dennisss/tansa/hardware/x260/README.md

260mm X Quadcopter Design
=========================

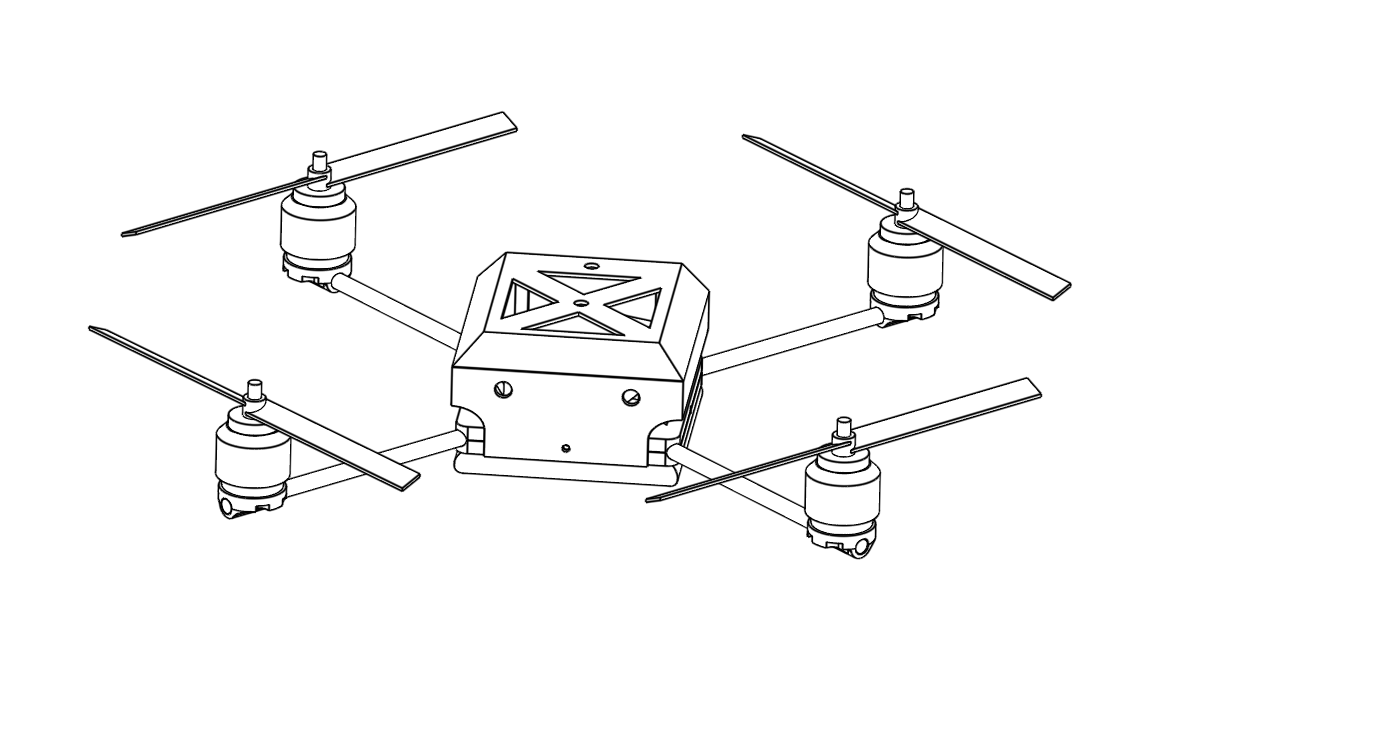
[picture p1: hardware/x260/wireframe.png]


Parts List
----------

- 4 of 138mm (length), 5mm (diameter) solid carbon fiber rods
	- https://hobbyking.com/en_us/turnigy-h-a-l-carbon-fiber-vertical-landing-skid-rod-5mm-x-250mm-4pcs-bag.html
- 2 of SLA/SLS printed center xframes
- 4 of SLA/SLS printed motor mounts
- PixRacer v1
- ACSP5 Power Board
- 4 of T-Motor MN1806 2300KV
- AfroESC Quattro 4 in 1 ESC
- Loctite Epoxy
- 2S 1500mAh LiPo Battery
- Assorted M3 Nylon Standoffs
- FrSky XM Receiver
