dennisss/tansa/hardware/x340/README.md

340mm X Quadcopter Design
=========================

Parts List
----------

- 4 T-Motor MT2208 Motors
- 1 Tenergy 3S 2700mAh Battery
- 1 PixRacer with ESP8266
- 1 AUAV ACSP4
- 4 AfroESC Slim 20A
- 2 Sparkfun Femtobuck LED drivers
- 2 Cree Cool White XPE-G2 LEDs
- 4 8030 Gemfan ABS propellers
- Assorted M3 screws
