dennisss/tansa/src/stereo/zed_info.txt

Use http://calib.stereolabs.com/?SN=1010 to get the factory calibration for the camera
