dennisss/tansa/src/stereo/full1.jpg

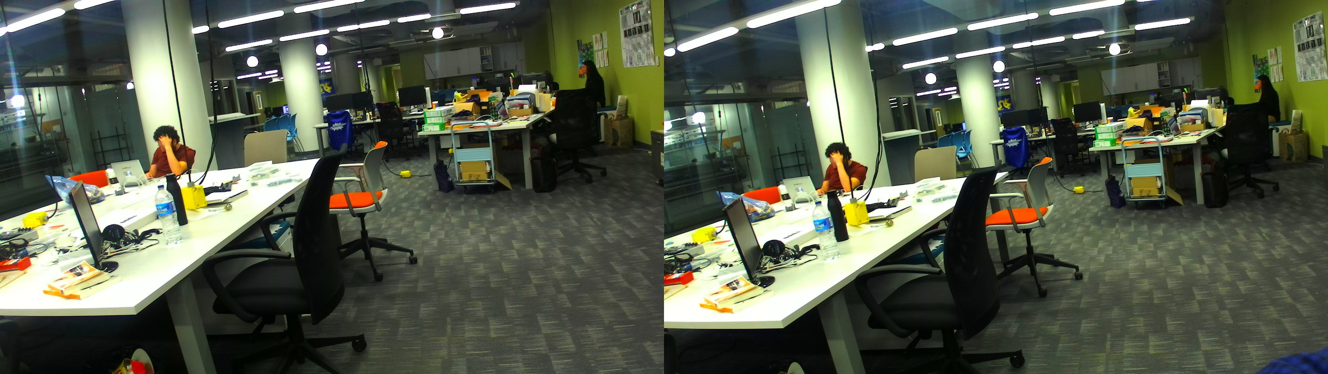
src/stereo/full1.jpg
