dennisss/tansa/src/stereo/full.jpg

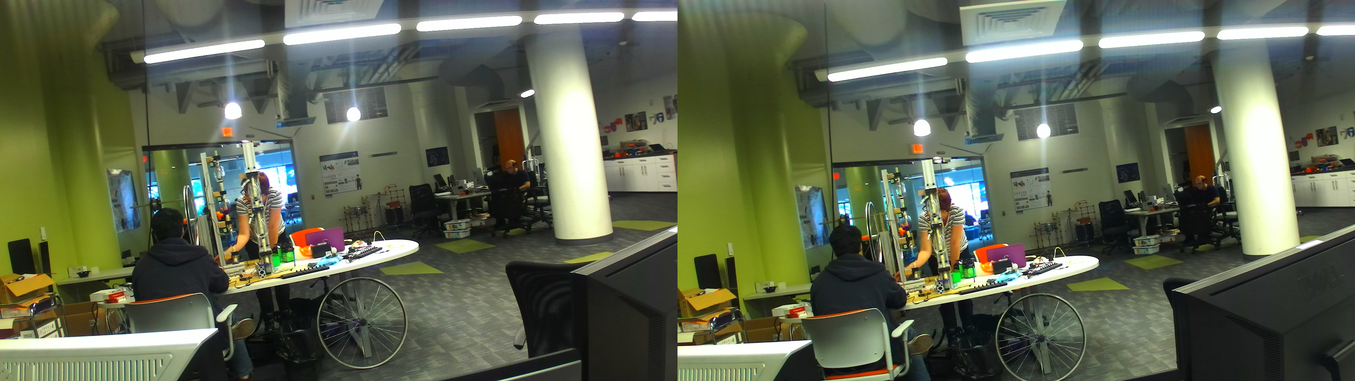
src/stereo/full.jpg
