dennisss/tansa/hardware/x260/active_ir/seeed_opl_bom.csv

Part/Designator | Manufacture Part Number/Seeed SKU | Quantity
R1 | 301010185 | 1
R2 | 301010196 | 1
R3,R4,R5 | 301010412 | 1
Q1 | 305030015 | 1
