dennisss/tansa/hardware/x260/mesh/shell.stl

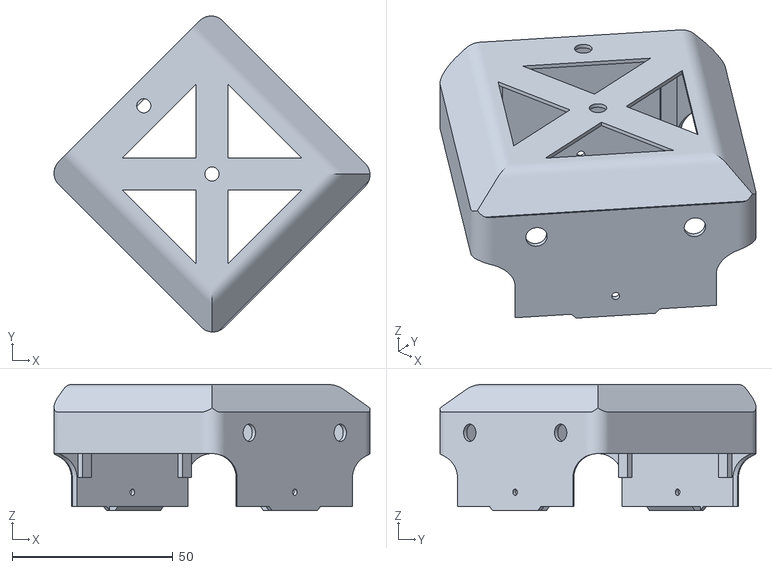
[picture p5: CAD file, 2017-04-13]
hardware/x260/mesh/shell.stl
98.2 x 98.2 x 39.2
