dennisss/tansa/hardware/x340/mesh/led-holder.stl

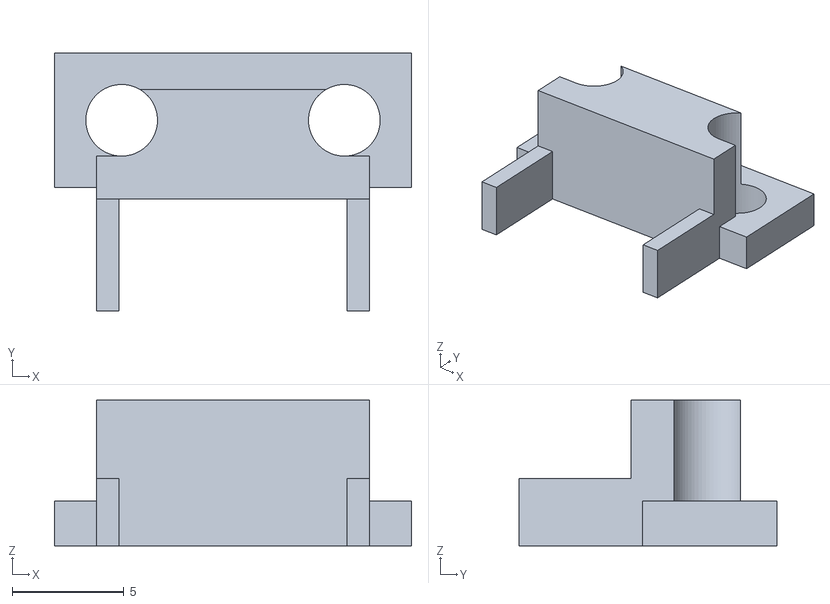
[picture p6: CAD file, 2017-03-05]
hardware/x340/mesh/led-holder.stl
15.9 x 11.5 x 6.50
