dennisss/tansa/public/models/propeller.stl

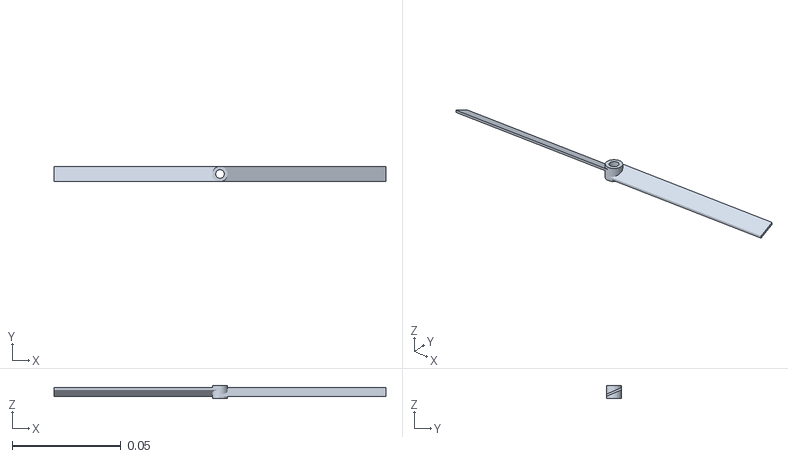
[picture p7: CAD file, 2017-03-05]
public/models/propeller.stl
0.152 x 0.007 x 0.006
