dennisss/tansa/hardware/x260/mesh/led-holder.stl

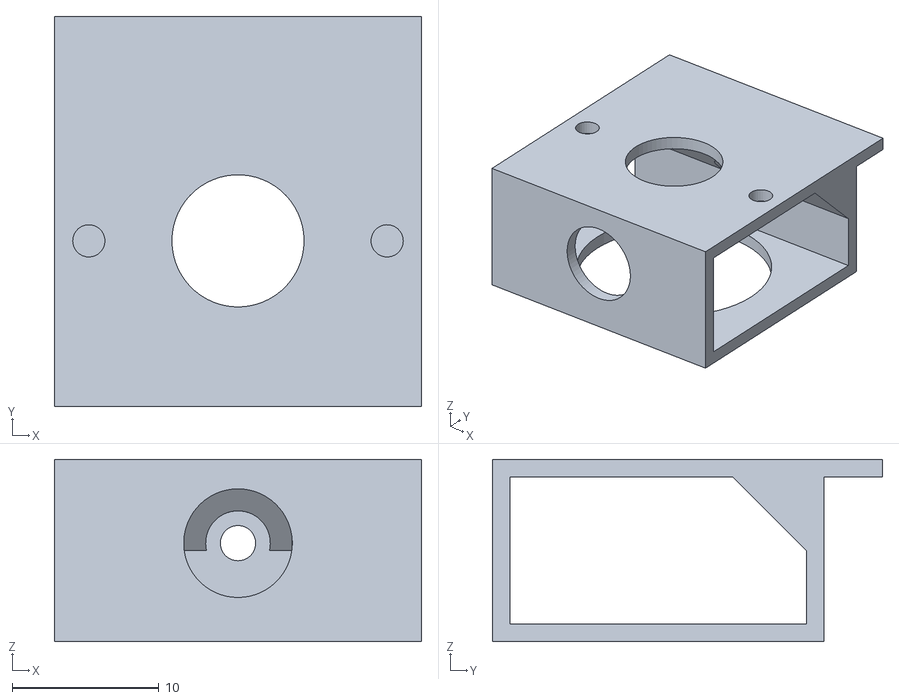
[picture p8: CAD file, 2017-04-13]
hardware/x260/mesh/led-holder.stl
25.0 x 26.6 x 12.4
