dennisss/tansa/hardware/x340/mesh/dot-rod-holder.stl

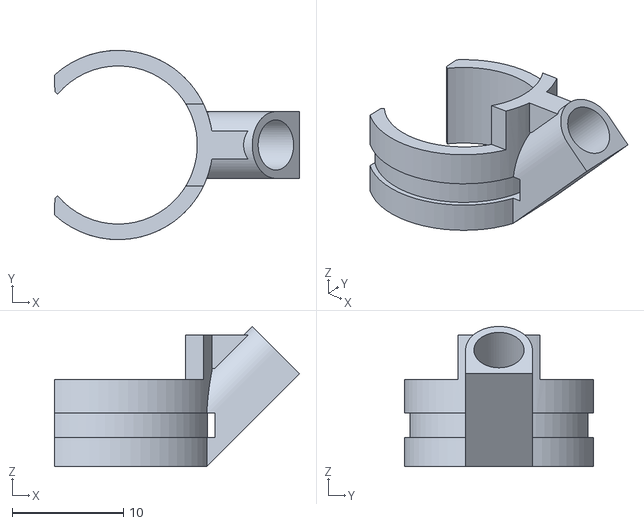
[picture p9: CAD file, 2016-11-03]
hardware/x340/mesh/dot-rod-holder.stl
22.0 x 17.0 x 12.6
