dennisss/tansa/public/models/body.stl

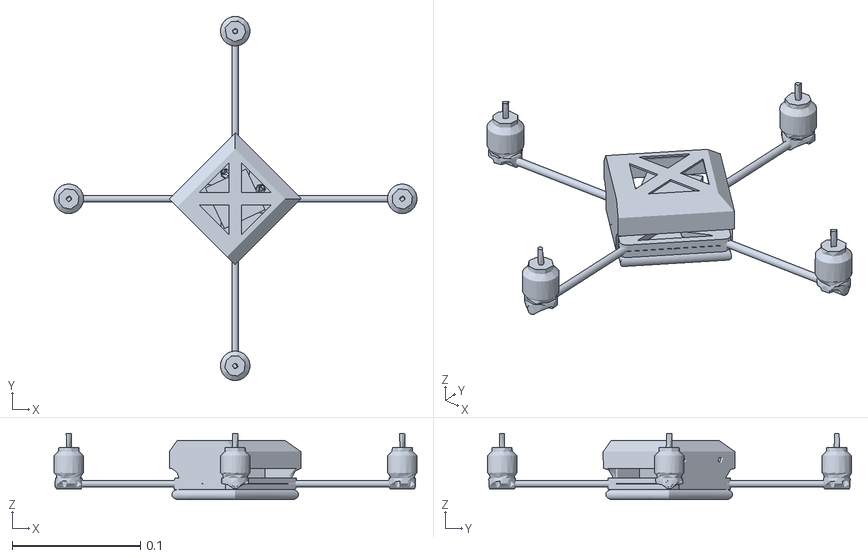
[picture p10: CAD file, 2017-03-05]
public/models/body.stl
0.283 x 0.284 x 0.0518
