dennisss/tansa/hardware/x260/mesh/cage.stl

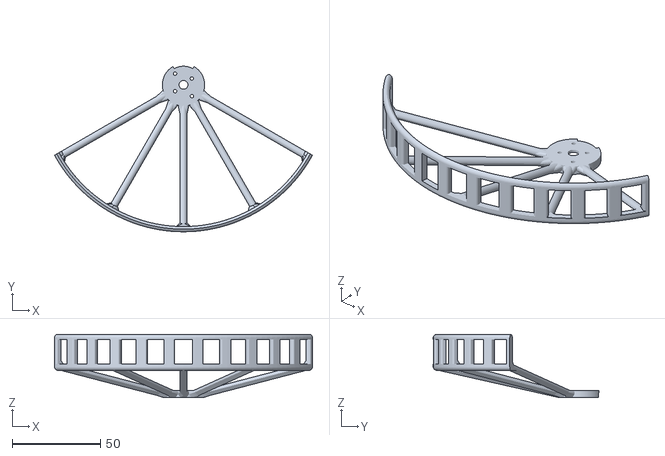
[picture p11: CAD file, 2017-04-13]
hardware/x260/mesh/cage.stl
146.6 x 94.1 x 35.9
