dennisss/tansa/hardware/x340/mesh/dot-holder.stl

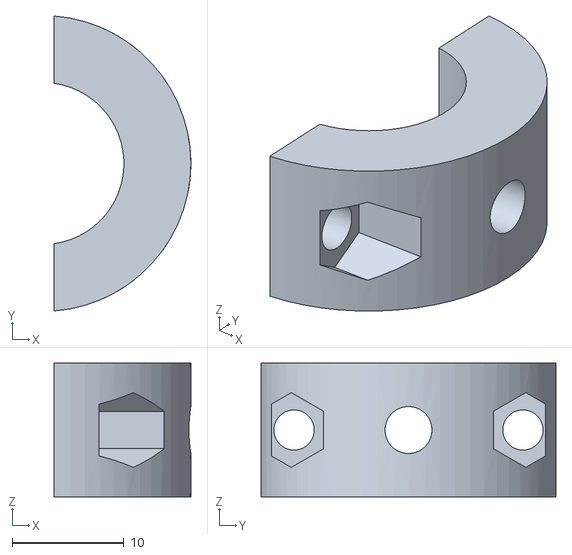
[picture p12: CAD file, 2016-10-07]
hardware/x340/mesh/dot-holder.stl
12.2 x 26.4 x 12.0
