dennisss/tansa/hardware/x260/mesh/xframe-bot.stl

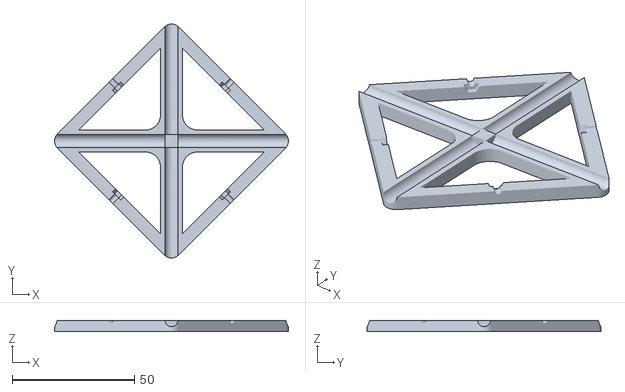
[picture p13: CAD file, 2017-03-06]
hardware/x260/mesh/xframe-bot.stl
95.7 x 95.7 x 4.40
