dennisss/tansa/hardware/x340/mesh/body.stl

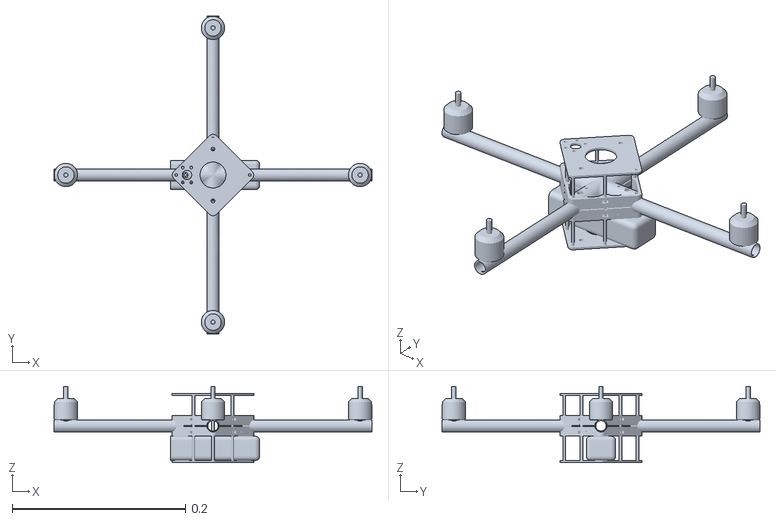
[picture p14: CAD file, 2016-10-07]
hardware/x340/mesh/body.stl
0.368 x 0.368 x 0.0879
