dennisss/tansa/hardware/x340/mesh/propeller.stl

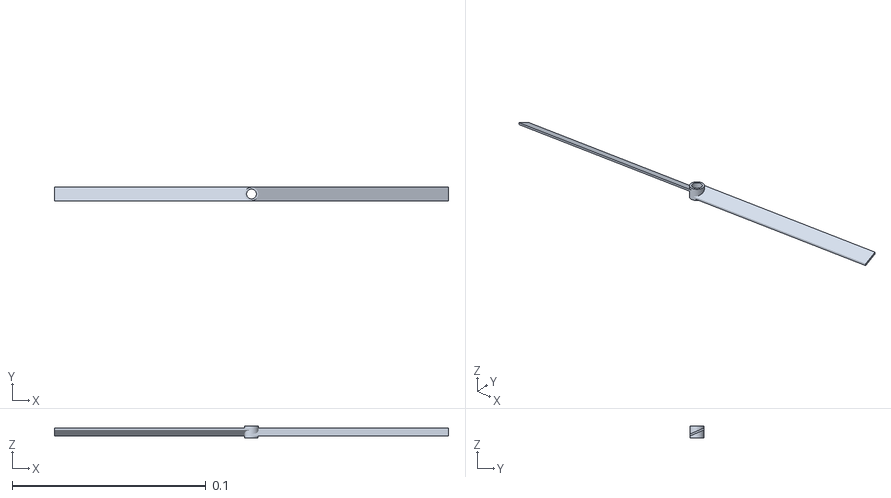
[picture p16: CAD file, 2016-10-07]
hardware/x340/mesh/propeller.stl
0.203 x 0.007 x 0.006
