dennisss/tansa/hardware/x260/mesh/motormnt.stl

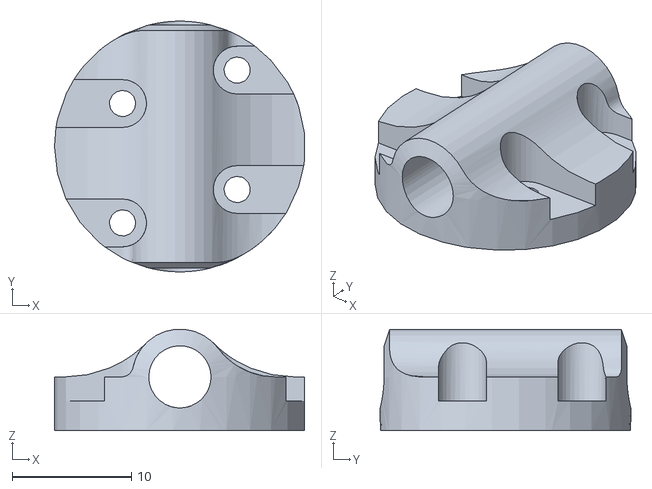
[picture p17: CAD file, 2017-03-05]
hardware/x260/mesh/motormnt.stl
20.9 x 21.0 x 8.48
