dennisss/tansa/hardware/x340/mesh/xframe.stl

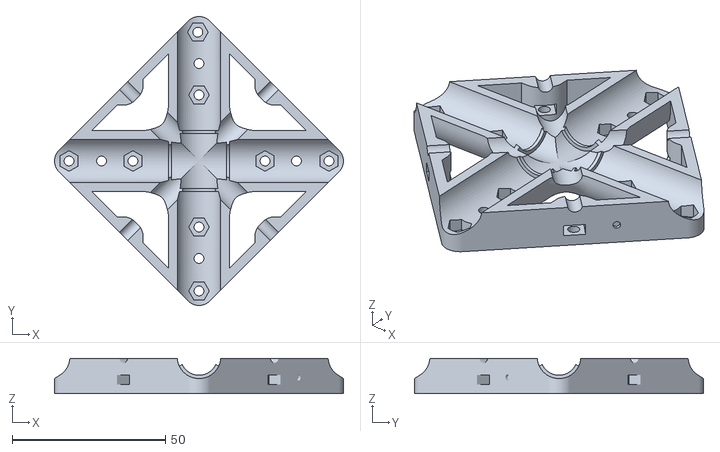
[picture p18: CAD file, 2016-10-02]
hardware/x340/mesh/xframe.stl
94.3 x 94.3 x 11.5
