dennisss/tansa/hardware/x260/mesh/foamshell.stl

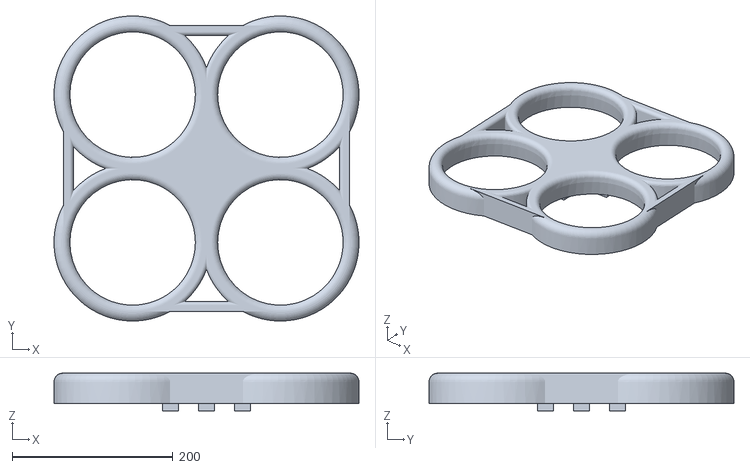
[picture p19: CAD file, 2017-03-05]
hardware/x260/mesh/foamshell.stl
379.4 x 379.4 x 47.0
