dennisss/tansa/hardware/x340/mesh/plate.stl

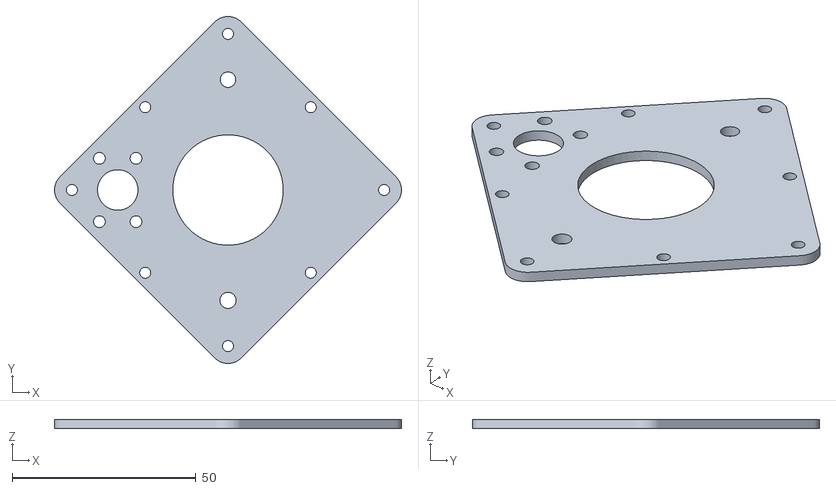
[picture p20: CAD file, 2016-09-28]
hardware/x340/mesh/plate.stl
94.3 x 94.3 x 2.38
