dennisss/tansa/hardware/x260/mesh/body.stl

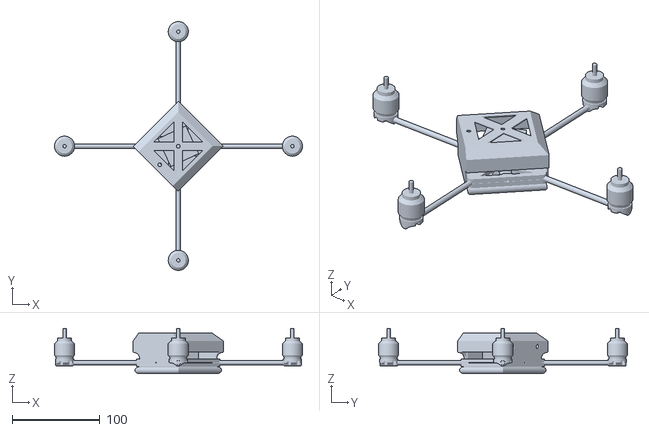
[picture p21: CAD file, 2017-03-05]
hardware/x260/mesh/body.stl
283.2 x 284.1 x 51.8
