dennisss/tansa/(list of files, cad)

Other CAD files:
hardware/x340/mech/battery.sldprt
hardware/x340/mech/plate.sldprt
hardware/x340/mech/rod.sldprt
hardware/x340/mech/xframe.sldprt
hardware/x340/mech/motor.sldprt
hardware/x340/mesh/plate.dxf
