dennisss/tansa/(threads)

Thread 15 (2016-10-01):

Latency Corrects

dennisss, 2016-10-01:
Not crucial right now, but needed for fast real world flight.
- Compute average latency to the drone via WiFi
- Given mocap position/velocity, forward predict position at the time when the drone should get the message
- In position controllers, use the forward prediction to compute control message

Closed 2017-04-04.

Thread 5 (2016-10-01):

Track drones using *active* IR

tessmichi, 2016-10-01:
Motion capture doesn't know which drone is which. IR will uniquely identify drones so paths can be sent to proper drones.

Might also be helpful for avoiding collision.

Engineers will work on making this work, but we have to ensure the code is actually making use of this capability.

Pending status from mechanical&computer engineering team.

abramowitzK, 2017-04-15:
This has been done by Dennis.

Closed 2017-04-15.

Thread 49 (2016-10-25):

Better Simulation Viewer

dennisss, 2016-10-25:
- Replace slow Gazebo Client
- Incorporate visualization of lighting
- Visually see the theater floor region as the ground plane
- Option to view from audience perspective (among others)

Eventually may roll into the choreography design GUI.

dmz38, 2017-02-20:
@dennisss I am going to consider this to be your web interface... yes?  Do you think that this can be ready for that Friday before Mike is here?

Closed 2017-03-05.

Thread 100 (2016-11-23):

Playing a jocs file again after running one causing drones to go insane (at least in simulator)

abramowitzK, 2016-11-23:
Need to reset jocs file after finishing the choreography and make sure we handle the case where they want to play it again.

Closed 2017-03-05.

Thread 126 (2017-01-30):

Fix breakpoint functionality and make sure it works

tessmichi, 2017-01-30:
Currently the GUI ability to add a breakpoint crashes the CLI so that should be fixed asap. Suggested fix: if no breakpoint, use start time=0

Assigning to Zach as discussed in requirements doc meeting

dmz38, 2017-02-25:
This is working per @abramowitzK's status update, ready for testing.

Thread 136 (2017-01-30):

Choreography input

tessmichi, 2017-01-30:
Create csv parsing logic, and add gui element to load csv file

dmz38, 2017-02-25:
GUI created, once back end logic is plugged in will change to an upload button, which will have all of the required info needed for backend team.

abramowitzK, 2017-03-05:
CSV parser is done. Adding new primitives currently

Closed 2017-03-15.

Thread 144 (2017-03-05):

New Primitives Integration

dennisss, 2017-03-05:
Trajectory code in #142

@dmz38 @abramowitzK see https://github.com/dennisss/tansa/blob/new/include/tansa/trajectory.h for the prototypes.

Below are some options/parameters that would need to be in the CSV:

Types:
- Ellipse
     - circle parameters but separate x and y radius
- Any trajectory rotated or translated
     - Angles rotationX, rotationY, rotationZ
     - OffsetX, offsetY, offsetZ
- Spiral: origin, radius, start time and angle, end time and angle
- Arcs:
     - n points and n times

dmz38, 2017-03-05:
RE: Trajectories from our good friend Dennis

[Rotating and translating occur] both at the same time. There is a TransformedTrajectory class that will take in both at once. setting one or the other to identity / zero vector will only do one.

I've found that rotating things usually takes them underground, so translation is very useful. especially because rotating a circle at (0,0,1) origin will make the origin at (0,1,0) potentially, so we should heed rotating before translating to the right origin

dennisss, 2017-03-05:
Also, this file contains examples of everything I simulated a week ago (https://github.com/dennisss/tansa/blob/master/src/custom.cpp#L1)

The easiest way to specify rotations would be to multiple together Eigen AxisAngle objects (https://github.com/dennisss/tansa/blob/master/src/custom.cpp#L166). In that line, it rotates pi/2 radians around the y-axis

dennisss, 2017-03-05:
Another small note: if making arcs, times must be exact integers, otherwise CGAL has a problem solving them.

abramowitzK, 2017-03-05:
Added support for ellipse, spiral and arc in CSV. Don't have Stationary points yet in CSV format so will have to adjust for that later.  Should you be able to specify velocity and acceleration at each point as well for arcs?

dennisss, 2017-03-05:
@abramowitzK Cool! We could specify those, but I think that wouldn't be as useful for users are those are harder to visualize. Maybe accelerations as that would specify the orientation at that point, but that's something we'd need to ask Mike if he'd want to use

abramowitzK, 2017-03-05:
@dennisss Okay sounds good. Can add that later. Working on transformed trajectories. A little tricky in csv.

abramowitzK, 2017-03-06:
Ellipse [x]
Spiral [x]
Transformed Trajectories [x]
Arc[ ]

Still having trouble with arcs, CGAL doesn't like the parameters I'm putting in, will have to experiment further.

dennisss, 2017-03-06:
@abramowitzK , keeping it to all round integer values has worked for me. It's been very stubborn in only operating in the rational number space, still looking for a way around that with using a harder to get library.

abramowitzK, 2017-03-06:
@dennisss Do the points have to be integers as well as the times?

dennisss, 2017-03-06:
@abramowitzK , maybe. Have never tried with non-integer points 🤔

abramowitzK, 2017-03-06:
@dennisss I'm triggering a very descriptive assert of ( j >= i ) somewhere in CGAL but my points are never integers because they are feet being converted to meters. I feel like the assert must be something else wrong though

abramowitzK, 2017-03-06:
minsnap.cpp
Crashes in this call in one of the CGAL routines
209: bool success = qp_solve(Q, A, b, rels, x, cost);

dennisss, 2017-03-06:
Ok. I think I found the issue. Writing a patch...  Also, I checked and we should be good on non-integer points

abramowitzK, 2017-03-06:
@dennisss awesome, thanks!

dennisss, 2017-03-06:
Try https://github.com/dennisss/tansa/commit/b55002c6928f4fd7fd3fc4267c0523a10f3d59d5 available in new2 branch

abramowitzK, 2017-03-06:
@dennisss still crashes. it tries to call set_d with i = 0 and j = 1 still

abramowitzK, 2017-03-06:
the matrix i have here is 10x10, is that what it is supposed to be?

abramowitzK, 2017-03-06:
what about this?

	// Copying values into program
	for(int i = 0; i < Q.rows(); i++) {
		for(int j = 0; j <= i; j++) {
			qp.set_d(i, j, Q(i, j));
		}
	}

dennisss, 2017-03-06:
Yeah, that should work. I am confused why we seem to have different versions of CGAL. You can try flipping the CGAL_USE_GMP #define at the top of that file.

dennisss, 2017-03-06:
Yeah, using the MP_Float does seem to make CGAL play nicer. It seem to allow non-integer times but is much slower.

abramowitzK, 2017-03-06:
Doesn't complain about integers but still fails to find solution. Here are my params
{
{{2,2,2}} <--Points not calling TransformedTrajectory::Stationary on them though will try that
{{4,4,4}}
}
{0, 5} <-- times

dennisss, 2017-03-06:
I'd think that for non-stationary endpoints, it's too under constrained and the best solution is at -infinity.

abramowitzK, 2017-03-06:
I'll keep trying. Might just have bad values or something because it seems like it should work now. but is_infeasable() (line 376 minsnap.cpp) is always true. Might just sleep on it and figure out tomorrow/tuesday

abramowitzK, 2017-03-06:
Think I found issue. Not with your code with mine. Will report back when I fix

abramowitzK, 2017-03-06:
Okay now it doesn't complain about integers but just makes an infeasible solution
(╯°□°）╯︵ ┻━┻
Bedtime

abramowitzK, 2017-03-06:
Did some testing. GMP does NOT work with non integer points. It gives completely different (incorrect) results when turned off.

dennisss, 2017-03-06:
ok. for now let's get the rest of the primitives merged, so that we have something ready for Mike with CSV

Closed 2017-04-01.

Thread 151 (2017-03-13):

CSV error checking/reporting

dennisss, 2017-03-13:
Catch exceptions. At the very least, offer a "catch all" and print out the last parsed line/cell number.

abramowitzK, 2017-03-13:
Will work on it. I thought I actually had done that...but let me see what's going wrong with this file.

Thread 155 (2017-09-04):

Compile error with gcc 7.1.1

nicolaerosia, 2017-09-04:
Hello,

Could you help me fixing this one
```
/home/user/aero-src/tansa/src/simulate/firmware.cpp: In constructor ‘tansa::Firmware::Firmware(const tansa::DataObject&, tansa::MultirotorModel::Ptr)’:
/home/user/aero-src/tansa/src/simulate/firmware.cpp:15:11: error: conversion from ‘const tansa::DataObject’ to ‘json {aka nlohmann::basic_json<>}’ is ambiguous
  json d = desc;
           ^~~~
In file included from /home/user/aero-src/tansa/include/tansa/core.h:4:0,
                 from /home/user/aero-src/tansa/include/tansa/model.h:4,
                 from /home/user/aero-src/tansa/include/tansa/simulate.h:8,
                 from /home/user/aero-src/tansa/src/simulate/firmware.cpp:1:
/home/user/aero-src/tansa/include/tansa/data.h:60:2: note: candidate: tansa::DataObject::operator T() const [with T = nlohmann::basic_json<>]
  operator T() const {
  ^~~~~~~~
In file included from /home/user/aero-src/tansa/include/tansa/data.h:4:0,
                 from /home/user/aero-src/tansa/include/tansa/core.h:4,
                 from /home/user/aero-src/tansa/include/tansa/model.h:4,
                 from /home/user/aero-src/tansa/include/tansa/simulate.h:8,
                 from /home/user/aero-src/tansa/src/simulate/firmware.cpp:1:
/home/user/aero-src/tansa/include/json.hpp:8375:5: note: candidate: nlohmann::basic_json<ObjectType, ArrayType, StringType, BooleanType, NumberIntegerType, NumberUnsignedType, NumberFloatType, AllocatorType, JSONSerializer>::basic_json(CompatibleType&&) [with CompatibleType = const tansa::DataObject&; U = tansa::DataObject; typename std::enable_if<((((! std::is_base_of<std::basic_istream<char>, U>::value) && (! std::is_same<U, nlohmann::basic_json<ObjectType, ArrayType, StringType, BooleanType, NumberIntegerType, NumberUnsignedType, NumberFloatType, AllocatorType, JSONSerializer> >::value)) && (! nlohmann::detail::is_basic_json_nested_type<nlohmann::basic_json<ObjectType, ArrayType, StringType, BooleanType, NumberIntegerType, NumberUnsignedType, NumberFloatType, AllocatorType, JSONSerializer>, U>::value)) && nlohmann::detail::has_to_json<nlohmann::basic_json<ObjectType, ArrayType, StringType, BooleanType, NumberIntegerType, NumberUnsignedType, NumberFloatType, AllocatorType, JSONSerializer>, U>::value), int>::type <anonymous> = 0; ObjectType = std::map; ArrayType = std::vector; StringType = std::__cxx11::basic_string<char>; BooleanType = bool; NumberIntegerType = long int; NumberUnsignedType = long unsigned int; NumberFloatType = double; AllocatorType = std::allocator; JSONSerializer = nlohmann::adl_serializer]
     basic_json(CompatibleType && val) noexcept(noexcept(JSONSerializer<U>::to_json(
     ^~~~~~~~~~
```

I have updated the json.hpp to latest found here https://github.com/nlohmann/json since I couldn't compile because of a "bug" there.

Thanks,
Nicolae

nicolaerosia, 2017-09-04:
This would fix my problem but I must admit I only looked for a couple of minutes
```
diff --git a/include/tansa/data.h b/include/tansa/data.h
index 07f1c1e..acebc2c 100644
--- a/include/tansa/data.h
+++ b/include/tansa/data.h
@@ -35,7 +35,7 @@ public:
                return DataObject(data[key]);
        }

-
+       const json& asJson() const { return data; }

        template<int N, int M>
diff --git a/src/simulate/firmware.cpp b/src/simulate/firmware.cpp
index 142afcf..2d1649d 100644
--- a/src/simulate/firmware.cpp
+++ b/src/simulate/firmware.cpp
@@ -12,8 +12,7 @@ Firmware::Firmware(const DataObject &desc, MultirotorModel::Ptr model) {
        currentActuatorOutputs.resize(4, 0);

        this->id = desc["id"];
-       json d = desc;
-       this->rcScript = d["rc"];
+       this->rcScript = desc.asJson()["rc"].get<string>();

        process = 0;
```

dennisss, 2017-09-04:
That looks reasonable. Changes on master now. Seems to be working, although I don't have 7.1.1 handy. Please close this issue if it is working on your machine now.

Closed 2017-09-04.

Thread 159 (2018-07-24):

Nodejs start.sh

tdnet12434, 2018-07-24:
Hi,
I have trouble with nodejs. The error shows up when execute the start.sh

> [2018-07-24 22:02:13] [connect] Successful connection
Waiting for osc messages...
  build [=         ] 10%events.js:160
      throw er; // Unhandled 'error' event
      ^

Error: listen EADDRINUSE :::4000
    at Object.exports._errnoException (util.js:1018:11)
    at exports._exceptionWithHostPort (util.js:1041:20)
    at Server._listen2 (net.js:1262:14)
    at listen (net.js:1298:10)
    at Server.listen (net.js:1394:5)
    at Object.<anonymous> (/home/fx/myquadcopter/tansa/src/server/node/index.js:24:8)
    at Module._compile (module.js:570:32)
    at Object.Module._extensions..js (module.js:579:10)
    at Module.load (module.js:487:32)
    at tryModuleLoad (module.js:446:12)
[2018-07-24 22:02:23] [connect] Successful connection
Server exited.

I'm too new to nodejs but interest in this repository.
Any advices are appriciate.
Thank you advanced!

dennisss, 2018-07-24:
`EADDRINUSE :::4000` means that you have some other server running on port 4000.  Close any conflicting programs, or change the port that tansa uses here: https://github.com/dennisss/tansa/blob/master/src/server/node/index.js#L24 and https://github.com/dennisss/tansa/blob/master/src/core/messaging.cpp#L25 .

tdnet12434, 2018-07-24:
Thank you @dennisss
My nomachine service is running on this port. After change port, it seems web GUI work normally.
But it seems to show up this when i run..
make runGcs
and ./spawn
I can see battery of vehicle is updated but runGcs process is suddenly gone.

Still loading...
Still loading...
Still loading...
Finished loading jocs
ID: 0 not calibrated!
Waiting for messages...
Finished loadConfiguration
[Vehicle] Connected!
terminate called after throwing an instance of 'nlohmann::detail::type_error'
  what():  [json.exception.type_error.302] type must be array, but is object
Aborted (core dumped)
Makefile:18: recipe for target 'runGcs' failed
make: *** [runGcs] Error 134

Thread 160 (2018-10-15):

spiral trajectory

schweinebauch, 2018-10-15:
Hello @dennisss
I tested your spiral trajectory, this trajectory can update position in XY(z = 0) plane, but I want to update this trajectory in XYZ, how can I modify spiral.py so that it can generate new s.position s.velocity and s.acceleration?
Could you please help me ?
@dennisss

schweinebauch, 2018-10-16:
Hello @dennisss, make sense!  Thanks for your help I modified what you said. Another question is, as you mentioned, this script is to simply take the symbolic expressions, there is no control feedback in it, trajectory errors can not be corrected.How can you guarantee the trajectory precision?
Looking forward to receiving your help.
@dennisss

dennisss, 2018-10-16:
@schweinebauch there's separate controller logic for following the trajectory (https://github.com/dennisss/tansa/blob/master/src/control/position.cpp#L500). It's the traditional PID controller approach that is discussed in most papers on this topic. It takes the current position in time of the trajectory of uses that as the PID setpoint and compares it to some externally given measurement of the current position. The output of that is an attitude/acceleration command to send to the drone.

Whether or not the controller will actually converge to the trajectory is a completely different issue of feasibility of the trajectory. Given pre-estimated maximum acceleration and velocity capabilities of a drone, we verify that a trajectory is physically possibly (https://github.com/dennisss/tansa/blob/master/src/model/feasibility.cpp) before ever running it through a live controller.

schweinebauch, 2018-10-16:
@dennisss Many thanks! You mentioned "the output of that is an attitude/acceleration command to send to the drone", under my understanding the PID calculated commands are sent to the inner control loop?
@dennisss

schweinebauch, 2018-10-17:
@dennisss thanks, make sense.Under my understanding, I think the evaluate() function calculates the setpoint of trajectory and measured position (maybe from ekf in inner controller loop) is as current position. The PID controller controls the errors between them which mentioned above. The outputs of PID also position, velocity and acceleration command will be sent to inner loop.
This is my opinion. Is it right?Because I think PID controller is much more easier to design and implement. Looking forward to your detailed suggestion.

dennisss, 2018-10-17:
@schweinebauch sounds mostly correct.  the measured pos/vel can be whatever you want as long as it is very accurate. we use a filtered motion capture position reading that we over time differentiate into a velocity reading as well (we don't use any data from the inner loop in the outer loop).  the inner ekf in our case is only responsible for maintaining an attitude measurement.

the input of our outer loop is the the measured pos/vel and the target pos/vel. As you mentioned correctly, the error is weighted to create the output. But the output in our implementation is ONLY the acceleration Note: we don't output a position or velocity command in this stage

Note that the target accel is not a part of the PID controller but is purely a feed forward term. we run the PID on pos/vel error to create an error correction command in terms of acceleration units and we then add the trajectory's acceleration to that before sending the command (without the feed forward addition, the PID output would only converge to a state with constant position and velocity)

the inner loop only receives a single scalar acceleration value per axis

schweinebauch, 2018-10-19:
@dennisss make sense. You are very kind!!! Thanks for your detailed answers. Is there a method in your work to control velocity? I mean in "compound trajectory"  two trajectories are added together, can I control the velocity respectively?For example I will add three trajectories together, the first one is a line, second one is semi-circle and third one is a line as well. Can I control the UAV velocity like this : 4m/s (in first trajectory)--> 1m/s(in second trajectory) --> 4m/s(in third trajectory)?
One more question is, can I control UAV velocity constantly while flying?
How can I modify your code?

Thanks!!

@dennisss

schweinebauch, 2018-10-24:
@dennisss  make sense! many thanks!
