dennisss/tansa/hardware/x340/mech/rod-dimensions.pdf

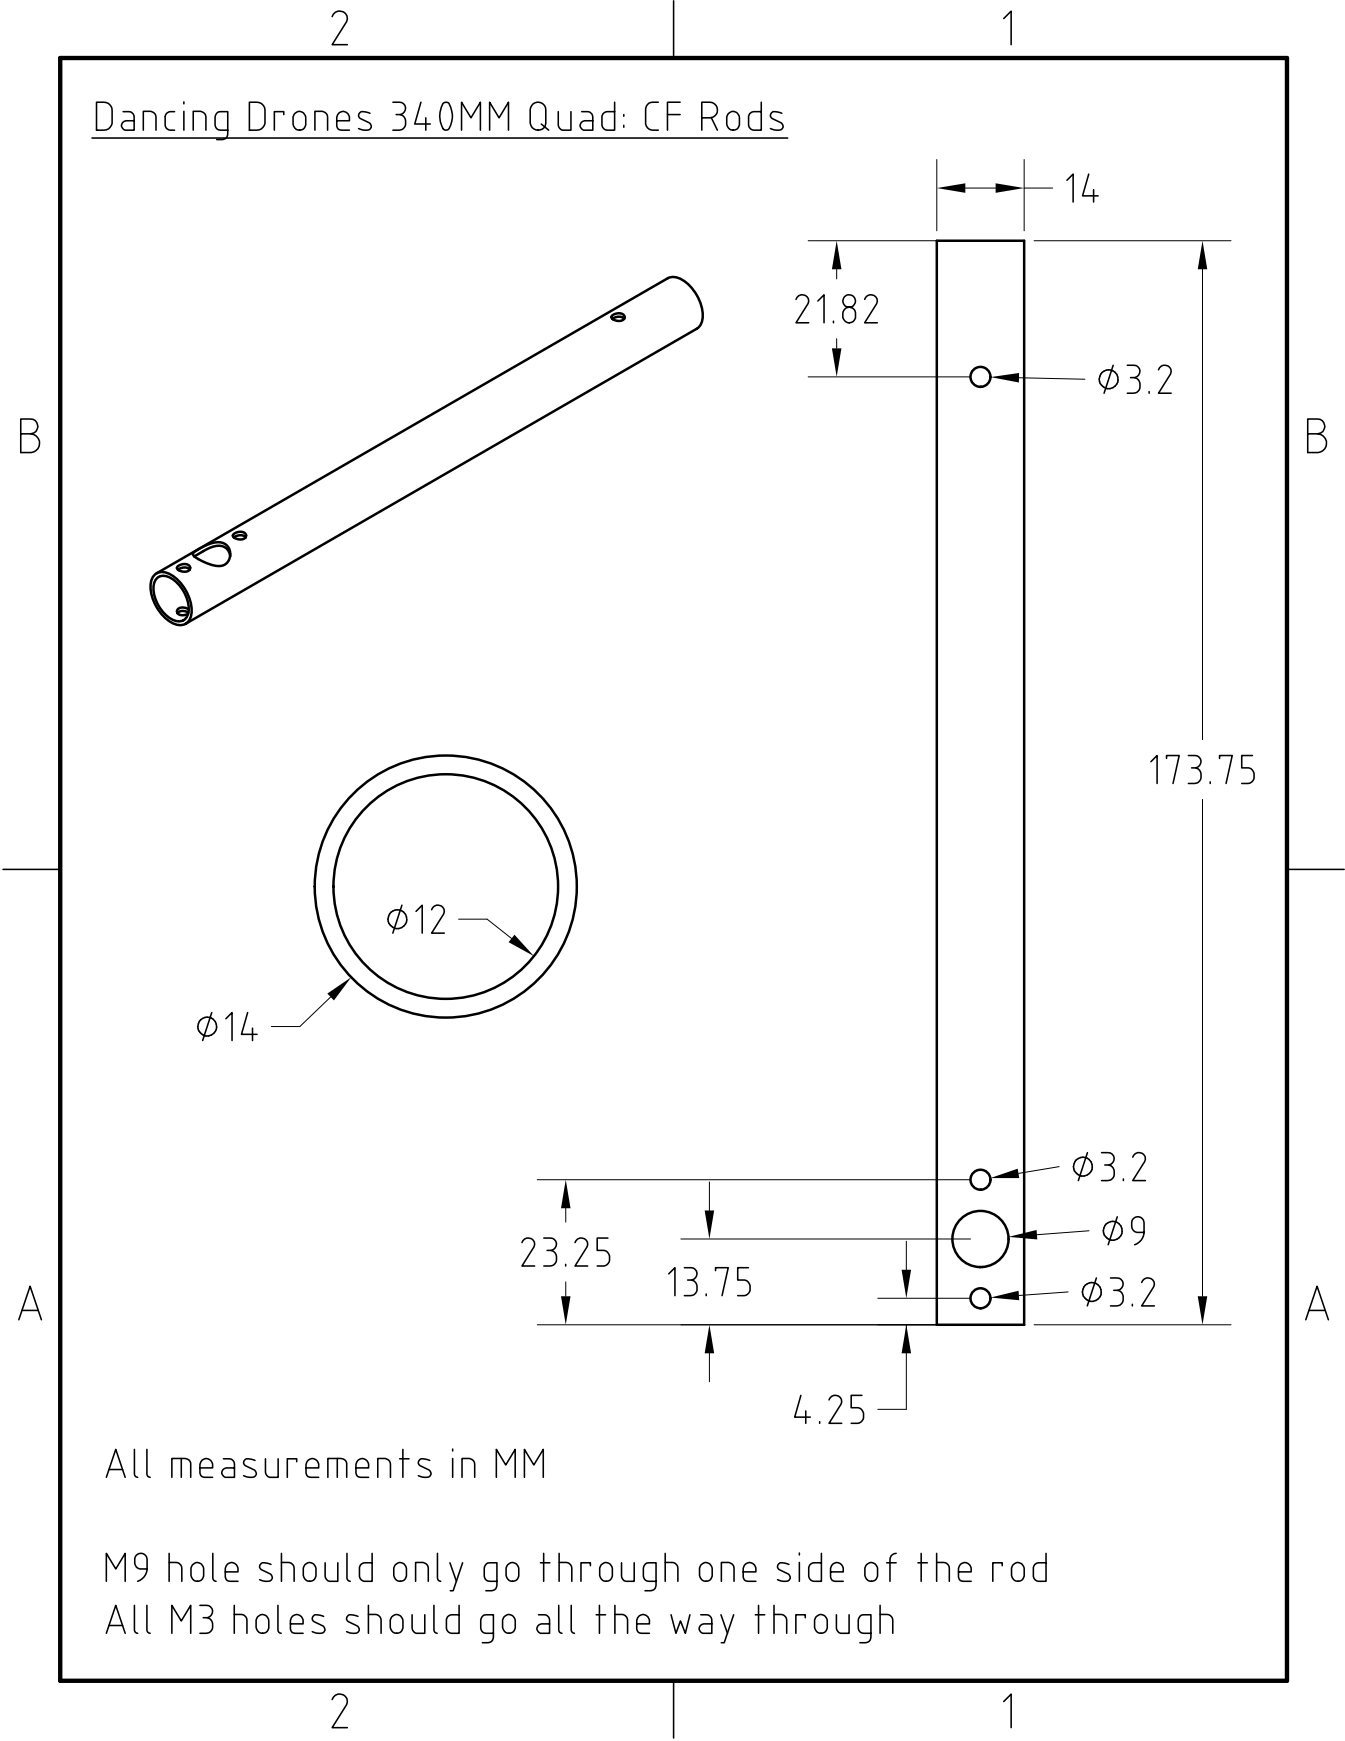
[picture p25: page 1]
