dennisss/tansa/hardware/x260/active_ir/activeIr.brd

## EAGLE design hardware/x260/active_ir/activeIr.brd (2017-03-05)

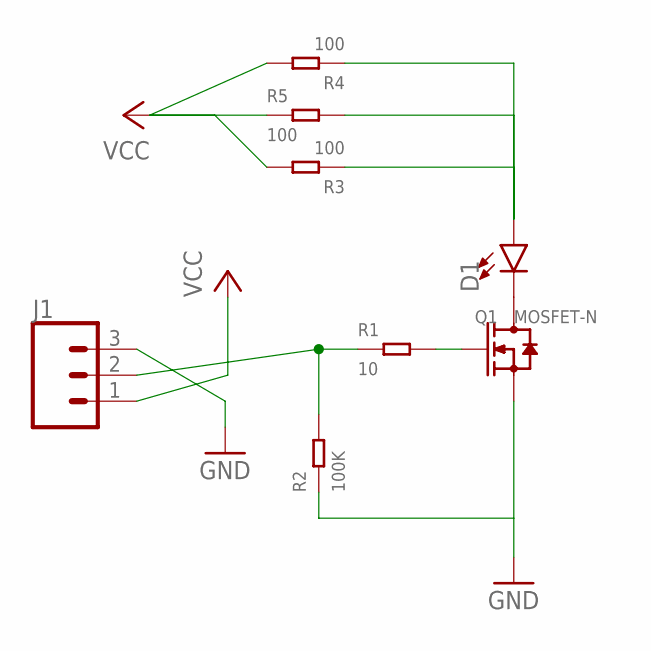
[picture p26: schematic activeIr.sch]

Parts:
D1: LED5MM; LED_5MM
J1: CONN_03SMD_RA_MALE; 1X03_SMD_RA_MALE
Q1: MOSFET-N; SOT-23
R1: 10; R0603
R2: 100K; R0603
R3, R4, R5: 100; R1206

Connections:
GND: J1.3, Q1.2 (S), R2.1
unnamed: D1.K (C), Q1.3 (D)
unnamed: Q1.1 (G), R1.2
unnamed: D1.A, R3.1, R4.1, R5.2
SIGNAL: J1.2, R1.1, R2.2
VCC: J1.1, R3.2, R4.2, R5.1

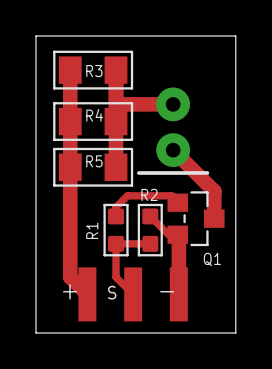
[picture p27: board activeIr.brd from above]

Board: 2 copper layers, 11.1 x 16.5 mm, 8 parts (1 on the bottom side), 6 nets.
