dennisss/tansa/include/tansa/csv.h

#ifndef TANSA_CSV_H
#define TANSA_CSV_H
#include <string>
#include <sstream>
#include <fstream>
#include <vector>
#include <map>
#include <iterator>
#include "action.h"
#include "vehicle.h"
#include "core.h"
#include "trajectory.h"
#include "routine.h"

namespace tansa {

const double FEET_TO_METERS = 0.3048;
const double DEGREES_TO_RADIANS = M_PI/180.0;
/**
 * Named constants for the columns in the CSV which are used for specific purposes
 */
enum csv_positions : uint32_t {
	BreakpointPos = 0,
	StartTimePos = 1,
	EndTimePos = 2,
	ActionTypePos = 3,
	DronesPos = 4,
	ParamStartPos = 5,
	LengthUnitPos = 6,
	AngleMeasurePos = 7,
	DroneKeyPos = 9,
};
/**
 * @struct
 * Holds all the information necessary to run a choreography.
 * Cleans up all resources when freed.
 */
class Choreography : public Routine {
public:
	virtual ~Choreography() {
		for(const auto& d: actions){
			for(const auto& a: d){
				delete a;
			}
		}
		for(const auto& drones: lightActions){
			for(const auto& lights: drones){
				for(const auto& action : lights){
					delete action;
				}
			}
		}
	}
};
/**
 *
 * @param data A string containing a string representation of an action
 * @return The enum version of passed in string action.
 */
ActionTypes parse_action_type(const std::string& data);
/**
 *
 * @param type The type of action
 * @return Whether or not the action is related to lighting.
 */
bool is_light_action(ActionTypes type);
/**
 *
 * @param line A line in a csv file
 * @return A vector of strings representing each cell of passed in line
 */
std::vector<string> read_csv_line(std::string& line);
/**
 * NOTE: Returns nullptr if file is invalid/has discontinuities
 * @param filepath Path to csv file
 * @return A choreography object representing data in that file.
 */
Choreography* parse_csv(const char* filepath, double scale);
/**
 *
 * @param time Given a time as a string (format SS.MS)
 * @return Double precision floating point representation of the given time string in seconds.
 */
double parse_time(std::string& time);
/**
 *
 * @param drone_field A string filed of the form (Drone1;Drone2; etc... )
 * @param drone_map Map of drone name to DroneId
 * @return
 */
std::vector<unsigned long> parse_drones(std::string drone_field, const std::map<std::string, unsigned long>& drone_map);
/**
 *
 * @param type Type of action
 * @param start Start time in seconds
 * @param end End time in seconds
 * @param droneid Numeric id of the drone.
 * @param split_line Split CSV line from parse_csv_line
 * @param length_conversion Conversion factor for length
 * @param angle_conversion Conversion factor for angle
 * @return The parsed action for the given drone.
 */
Action* parse_motion_action(ActionTypes type,
							double start,
							double end,
							unsigned long droneid,
							std::vector<std::string> split_line,
							double length_conversion = 1.0,
							double angle_conversion = 1.0);
/**
 *
 * @param type Type of action
 * @param start Start time in seconds
 * @param end End time in seconds
 * @param droneid Numeric id of the drone.
 * @param split_line Split CSV line from parse_csv_line
 * @return The parsed action for the given drone.
 */
LightAction* parse_light_action(ActionTypes type, double start, double end, unsigned long droneid, std::vector<std::string> split_line);
/**
 *
 * @param type Type of action
 * @param start Start time in seconds
 * @param end End time in seconds
 * @param droneid Numeric id of the drone.
 * @param split_line Split CSV line from parse_csv_line
 * @param length_conversion Conversion factor for length
 * @return The parsed HoverAction for the given drone.
 */
Action* parse_hover_action(double start, double end, unsigned long droneid, const std::vector<std::string>& split_line, double length_conversion);
/**
 *
 * @param type Type of action
 * @param start Start time in seconds
 * @param end End time in seconds
 * @param droneid Numeric id of the drone.
 * @param split_line Split CSV line from parse_csv_line
 * @param length_conversion Conversion factor for length
 * @return The parsed LineAction for the given drone.
 */
Action* parse_line_action(double start, double end, unsigned long droneid, const std::vector<std::string>& split_line, double length_conversion);
/**
 *
 * @param type Type of action
 * @param start Start time in seconds
 * @param end End time in seconds
 * @param droneid Numeric id of the drone.
 * @param split_line Split CSV line from parse_csv_line
 * @param length_conversion Conversion factor for length
 * @param angle_conversion Conversion factor for angle
 * @return The parsed CircleAction for the given drone.
 */
Action* parse_circle_action(double start, double end, unsigned long droneid, const std::vector<std::string>& split_line, double length_conversion, double angle_conversion);
/**
 *
 * @param type Type of action
 * @param start Start time in seconds
 * @param end End time in seconds
 * @param droneid Numeric id of the drone.
 * @param split_line Split CSV line from parse_csv_line
 * @param length_conversion Conversion factor for length
 * @param angle_conversion Conversion factor for angle
 * @return The parsed EllispseAction for the given drone.
 */
Action* parse_ellipse_action(double start, double end, unsigned long droneid, const std::vector<std::string>& split_line, double length_conversion, double angle_conversion);

Action* parse_helix_action(double start, double end, unsigned long droneid, const std::vector<std::string>& split_line, double length_conversion, double angle_conversion);


/**
 *
 * @param type Type of action
 * @param start Start time in seconds
 * @param end End time in seconds
 * @param droneid Numeric id of the drone.
 * @param split_line Split CSV line from parse_csv_line
 * @param length_conversion Conversion factor for length
 * @param angle_conversion Conversion factor for angle
 * @return The parsed SpiralAction for the given drone.
 */
Action* parse_spiral_action(double start, double end, unsigned long droneid, const std::vector<std::string>& split_line, double length_conversion, double angle_conversion);
/**
 *
 * @param type Type of action
 * @param start Start time in seconds
 * @param end End time in seconds
 * @param droneid Numeric id of the drone.
 * @param split_line Split CSV line from parse_csv_line
 * @param length_conversion Conversion factor for length
 * @return The parsed ArcAction for the given drone.
 */
Action* parse_arc_action(double start, double end, unsigned long droneid, const std::vector<std::string>& split_line, double length_conversion);
/**
 * Any trajectory rotated or translated
 * @param type Type of action
 * @param start Start time in seconds
 * @param end End time in seconds
 * @param droneid Numeric id of the drone.
 * @param split_line Split CSV line from parse_csv_line
 * @param length_conversion Conversion factor for length
 * @param angle_conversion Conversion factor for angle
 * @return The parsed trajectory for the given drone.
 */
Action* parse_trajectory_action(double start, double end, unsigned long droneid, const std::vector<std::string>& split_line, double length_conversion, double angle_conversion);
/**
 *
 * @param type Type of action
 * @param start Start time in seconds
 * @param end End time in seconds
 * @param droneid Numeric id of the drone.
 * @param split_line Split CSV line from parse_csv_line
 * @return The parsed LightAction for the given drone.
 */
LightAction* parse_light_action(double start, double end, unsigned long droneid, const std::vector<std::string>& split_line);
/**
 *
 * @param type Type of action
 * @param start Start time in seconds
 * @param end End time in seconds
 * @param droneid Numeric id of the drone.
 * @param split_line Split CSV line from parse_csv_line
 * @return The parsed StrobeAction for the given drone.
 */
LightAction* parse_fade_action(double start, double end, unsigned long droneid, const std::vector<std::string>& split_line);
/**
 *
 * @param type Type of action
 * @param start Start time in seconds
 * @param end End time in seconds
 * @param droneid Numeric id of the drone.
 * @param split_line Split CSV line from parse_csv_line
 * @return The parsed StrobeAction for the given drone.
 */
LightAction* parse_strobe_action(double start, double end, unsigned long droneid, const std::vector<std::string>& split_line);
/**
 *
 * @param type Type of action
 * @param start Start time in seconds
 * @param end End time in seconds
 * @param droneid Numeric id of the drone.
 * @param split_line Split CSV line from parse_csv_line
 * @return The parsed StrobeAction for the given drone.
 */
LightAction* parse_dynamic_strobe_action(double start, double end, unsigned long droneid, const std::vector<std::string>& split_line);

/**
 * Replaces all empty actions with transitions
 * @param actions 2D array of action pointers
 */
void insert_transitions(std::vector<std::vector<Action*>>& actions, const std::vector<Point>& homes);
/**
 *
 * @param point A string representing a point
 * @return The tansa::point representation parse from a string.
 */
Point parse_point(std::string point);

LightController::LightIndices parse_light_index(const std::string& in);
void fill_light_gaps(std::vector<std::vector<std::vector<LightAction*>>>& actions, double end_time);
}
#endif
