dennisss/tansa/include/tansa/jocsParser.h

#ifndef TANSA_JOCSPARSER_H
#define TANSA_JOCSPARSER_H
#include <string>
#include <fstream>
#include <iostream>
#include <vector>
#include <memory>
#include "json.hpp"
#include "tansa/vehicle.h"
#include "tansa/core.h"
#include "tansa/trajectory.h"
#include "tansa/routine.h"


namespace tansa {
/**
 * @class Represents and encapsulates choreographies.
 */
class Jocs : public Routine {
public:
	static const std::string HOME_KEY;
	static const std::string ID_KEY;
	static const std::string CHOREOGRAPHY_KEY;
	static const std::string STARTPOS_KEY;
	static const std::string ENDPOS_KEY;
	static const std::string DURATION_KEY;
	static const std::string ACTION_ROOT_KEY;
	static const std::string ACTION_TIME_KEY;
	static const std::string ACTION_TYPE_KEY;
	static const std::string DRONE_ARRAY_KEY;
	static const std::string ACTION_DATA_KEY;
	static const std::string CIRCLE_ORIGIN_KEY;
	static const std::string CIRCLE_RADIUS_KEY;
	static const std::string CIRCLE_THETA1_KEY;
	static const std::string CIRCLE_THETA2_KEY;
	static const std::string UNITS_KEY;
	static const double FEET_TO_METERS;
	static const double DEGREES_TO_RADIANS;
	static const std::string THEATER_VOLUME_KEY;
	static const std::string MIN_KEY;
	static const std::string MAX_KEY;
	static const std::string LENGTH_KEY;
	static const std::string TIME_KEY;
	static const std::string ANGLE_KEY;
	static const std::string REPEAT_KEY;
	static const std::string DRONE_START_OFF_KEY;
	static const std::string DRONE_END_OFF_KEY;
	static const std::string HOVER_KEY;
	static const std::string DRONE_OFF_KEY;
    static const std::string BREAK_KEY;
    static const std::string BREAK_NAME;
    static const std::string BREAK_START;
    static const std::string BREAK_NUMBER;
	static const std::string START_INTENSITY_KEY;
	static const std::string END_INTENSITY_KEY;
	static const std::string BPS_KEY;
	//static const std::string LIGHTS_INCL_KEY;

	friend Jocs *custom_jocs();

	/**
	 * Constructs a Jocs instance that encapsulates a choreography
	 * @param convertMeters If true, the input units of length will be taken as feet and will be converted to meters
	 * @param convertRadians If true, the input units of angle will be taken as degrees and will be converted to radians
	 * @param numRepeat How many times should the choreography repeat?
	 * @return
	 */
	Jocs(bool convertMeters, bool convertRadians, unsigned numRepeat) : Routine(), repeat(numRepeat){
		this->needConvertToMeters = convertMeters;
		this->needConvertToRadians = convertRadians;
	}
	virtual ~Jocs();
	/**
	 * Parses a given Jocs file
	 * @public
	 * @param jocsPath String containing path from working directory to jocsFile
	 * @return A vector containing unique_ptrs to Actions
	 */
	static Jocs* Parse(std::string jocsPath, double scale);
	/**
	 * @return The starting positions of the drones in the given Choreography.
	 */
	inline std::vector<Point> GetHomes() const { return homes; }
	/**
	 * @return Returns a std::vector where each index of the vector contains the actions for a drone of DroneId == index
	 */
	inline const std::vector<std::vector<Action*>>& GetActions() const { return actions; }
	/**
	 * @return Returns a std::vector where each index of the vector contains the light actions for a drone of DroneId == index
	 */
	inline const std::vector<std::vector<std::vector<LightAction*>>>& GetLightActions() const { return lightActions; }
	/**
	 * @return Returns a std::vector of Breakpoints that are present in the choreography represented by this object.
	 */
	inline std::vector<Breakpoint> GetBreakpoints() const { return breakpoints; }


	// TODO: this should be taken away from here and jocsPlayer and made a member of Action!!!!
	//bool isMotionAction(Action* a);

private:

	unsigned repeat;

	/**
	 * Parse all actions in a given Jocs json object
	 * @private
	 * @param data [in] Jocs json data
	 * @param actions [out] Will be filled with actions
	 */
	 void parseActions(const nlohmann::json &data, double scale);
	/**
	 * Parse all breakpoints in a given Jocs json object representing list of breakpoints
	 * @private
	 * @param data [in] Jocs json data
	 */
	void parseBreakpoints(const nlohmann::json &data);
	/**
	 * Parses a singular action array
	 * @private
	 * @param data Json data containing a reference to an action
	 * @param actions [out] Will be filled with actions
	 */
	 double parseAction(nlohmann::json::reference data, double lastTime, double scale);
	/**
	 * Converts from string to ActionTypes enum
	 * @private
	 * @param data A string containing the ascii representation of an ActionType
	 * @return Action type as the enum
	 */
	 ActionTypes convertToActionType(const std::string& data);

	/**
	 * Generates action array with specific breakpoints for start to end
	 * @private
	 * @param data A string containing the ascii representation of an ActionType
	 * @return Action type as the enum
	 */

};

Jocs *custom_jocs();

}
#endif //TANSA_JOCSPARSER_H
