dennisss/tansa/include/tansa/gazebo.h

#ifndef TANSA_GAZEBO_H_
#define TANSA_GAZEBO_H_

#include "vehicle.h"
#include "trajectory.h"

#include <map>
#include <vector>
#include <string>

namespace tansa {

/**
 * For connecting to a running Gazebo simulation
 */
class GazeboConnector {
public:
	GazeboConnector();

	void connect();
	void disconnect();
	void track(Vehicle *v, int id);

	void clear();

	/**
	 * Places drone models into the simulation environment at the given positions
	 */
	void spawn(const std::vector<Point> &homes, std::string sdf_file, std::string rcs_file);

};


}

#endif
