dennisss/tansa/(commit log)

2016-09-26 Adding a lot of stuff / screw ROS
2016-09-28 Add in physical design and documentation pictures
    [plate.stl, xframe.stl]
2016-10-02 Abstracting linear to polynomial. Demo is now smooth circle to square
    [xframe.stl]
2016-10-06 Add sample choreography file based off of first test simulation for 6 drones in 2 groups. Also modify .gitignore to ignore CLion files.
2016-10-07 Add more realistic model
    [body.stl, dot-holder.stl, multirotor_base.xacro, propeller.stl, x340.xacro, x340_base.xacro]
2016-10-13 Closer to reality simulation parameters
    [x340.xacro]
2016-10-14 Fixed some compiler issues and slightly modified action classes
    [action.h]
2016-10-15 Finished parsing lines as example. Updated make file to use C++14. Fixed private inheritance in classed derived from Action
    [action.h, jocsParser.cpp, jocsParser.h]
2016-10-15 Added proper comments to jocsParser and fixed minor code/style issues
    [jocsParser.cpp, jocsParser.h]
2016-10-15 Added proper comments to action.h and some minor code/style fixes
    [action.h]
2016-10-15 Fixed several constants that need to be changed due to updates to jocs. Also began implementing the transitions as an example
    [action.h, jocsParser.cpp, jocsParser.h]
2016-10-18 fixed compiler errors. Haven't tested for correctness yet
    [jocsParser.cpp, jocsParser.h]
2016-10-19 Implemented reading from and flying from a basic jocs file for one drone. Having trouble getting gazebo to run correctly. Still troubleshooting
    [action.h, jocsParser.cpp, jocsParser.h]
2016-10-20 fixes #32
    Added logic to auto convert feet to meters and degrees to radians
    [jocsParser.cpp, jocsParser.h]
2016-10-21 Adding in socket.io cpp submodule
2016-10-22 Fixed many warnings. Turned on -Wall. There are still a few more warnings that need review
    [action.h, jocsParser.cpp, polynomial.cpp, trajectory.h, vehicle.h]
2016-10-22 Removed comments from jocs files using regex when parsing. Still need to fix up the choreography_line_data file to use grouping. Fixed missing brackets at the end of it
    [jocsParser.cpp, jocsParser.h]
2016-10-25 Cleanup main, add vehicle battery and termination stuff
    [dot-rod-holder.stl]
2016-11-06 Improve socket.io compile settings
2016-11-12 Fixed demo_sim merge issues
    [jocsParser.cpp, jocsParser.h]
2016-11-12 Fixed some memory leaks and added checking to make sure the jocs file opens. If it does not, we throw and exception with a helpful message
    [jocsParser.cpp, jocsParser.h]
2016-11-12 Fixed up more of the choreography. Also added checking for discontinuities in jocs files. Throw runtime exceptions with helpful messages if discontinuity detected.
    [action.h, jocsParser.cpp]
2016-11-12 Fixed a memleak with the exceptions I was throwing
    [jocsParser.cpp]
2016-11-12 Working on fixing the choreography file using the checkers
    [jocsParser.cpp]
2016-11-12 Made error messages for time discontinuity better
    [jocsParser.cpp]
2016-11-12 Fixed missing regex call
    [jocsParser.cpp]
2016-11-13 Try to fix circle by switching direction
2016-11-15 Adding static ips for mocap setup and better calibration
2016-11-17 add headers and empty methods - doesn't compile since nothing is returned. this is just a placeholder making the methods defined in #83
    [jocsParser.cpp, jocsParser.h]
2016-11-17 Added breakpoint logic to player class - also modify code so that it currently compiles
2016-11-18 First cut.
2016-11-18 Add framework for Light trajectory
2016-11-19 Add legit landings to state machine and refactor player
2016-11-19 Fix compile time errors in parsing lights and start handling lights in Player class
    [action.h, jocsParser.cpp, jocsPlayer.cpp]
2016-11-19 Move vehicle calibration params to separate file and add working json messages
2016-11-19 Fix runtime error from deleting an action
    [jocsPlayer.cpp]
2016-11-19 Adding kill switch
2016-11-20 Fix code issues to run without crashing - still doesn't send correct light values though
    [jocsPlayer.cpp]
2016-11-20 Fix lighting to be treated as an independant action. Still only does both lights at once though
    [jocsPlayer.cpp]
2016-11-20 Fix -0 values due to using longs
    [jocsPlayer.cpp, light.cpp]
2016-11-21 Attempt to fix resuming from a pause.
    [jocsPlayer.cpp, jocsPlayer.h]
2016-11-21 Shorten intensity buffer, start rough choreography update to new edits
    [control.h]
2016-11-21 update epsilon to be smaller, fix breakpoint time differences
    [control.h]
2016-11-22 Fix bug where drones are sent to wrong index's home position
    [jocsPlayer.cpp]
2016-11-22 Fixes for pr #95
    [jocsParser.cpp, strobe.cpp]
2016-11-22 Fix requested for pr #95
    [jocsPlayer.cpp]
2016-11-22 try fixing tornado but get spacial distoninuity when shouldn't'
    [jocsParser.cpp]
2016-11-22 fix things that shouldnt be pushed
    [jocsParser.cpp]
2016-11-24 Improving takeoff, landing, and ground behavior
2016-11-24 Add hover point calibration procedure
2016-11-24 Laying out some new trajectory prototypes
2016-11-25 Fix strobe trajectory logic and add ability to parse strobe from jocs file
    [action.h, jocsParser.cpp, jocsParser.h, strobe.cpp, trajectory.h]
2016-11-25 Fix warning for defining members in different order than they're assigned in
    [trajectory.h]
2016-11-25 Fix order of values in strobe; fix bps to be 46 'cycles' total rather than per second
    [strobe.cpp]
2016-11-25 GUI updates, make landing and pausing smarter.
2016-11-25 Fixed some CSS issues with smaller screens Changed current time from seconds to minutes and seconds (no partial seconds)
2016-11-25 Added code to prevent drones from taking off (preparing) if they are not being tracked.
    [jocsPlayer.cpp]
2016-11-26 Add additional checks before loading a new file, fix resuming from a pause.
    [jocsPlayer.cpp, jocsPlayer.h]
2016-11-27 want to print times in lab comp
2016-11-27 print time at interval of 5
2016-11-27 Fixes for running <6 drones
    [jocsPlayer.cpp]
2016-11-27 Use jocsConfig for vehicles if gui doesn’t send them
    [jocsPlayer.cpp]
2017-02-10 Re-organize hardware designs
    [battery.sldprt, body.stl, dot-holder.stl, dot-rod-holder.stl, led-holder.stl, motor.sldprt, plate.dxf, plate.sldprt]
2017-02-10 New 260mm quad design
    [activeIr.brd, activeIr.sch, body.stl, motormnt.stl, seeed_opl_bom.csv, shell.stl, xframe.stl]
2017-02-10 Refactor PX4 scripts and add new vehicle methods
    [foamshell.stl, led-holder.stl, motormnt.stl, shell.stl]
2017-02-10 Some fixes to the prior stuff
    [body.stl]
2017-02-13 Initial simulation implementation
    [activeIr.brd, activeIr.sch]
2017-02-19 Some integration of new sim into gcs
    [body.stl, drone.stl, propeller.stl]
2017-02-28 Lot’s of things in progress
2017-03-03 Started implementing a csv parser to replace jocsParser
    [test.csv]
2017-03-03 Parsing line,hover,transition,circle. Needs testing though
    [test.csv]
2017-03-04 Finished parsing all motion actions. Also added discontinuity checker, transition inserter. Still no support for light actions
2017-03-04 Fixed parser to only read first drone from line and ignore others to avoid mistakes. Until we support offsets
    [csv.cpp]
2017-03-04 Got homes working
    [test.csv]
2017-03-04 Back to binary meshes for web viewer
    [body.stl, propeller.stl]
2017-03-05 Added scaling and unit conversion in CSV
    [hover.csv]
2017-03-05 fixed up some comments
    [csv.h]
2017-03-05 Fixed up example data file
    [hover.csv, test.csv]
2017-03-05 Viewer and Player Fixes
    [jocsPlayer.cpp, jocsPlayer.h]
2017-03-05 Fixed bug, not converting home positions to meters if they were in feet
    [csv.cpp]
2017-03-05 Started adding new primatives. Also changed actiontype to be a scoped enum to prevent wierd namespace clashing with useless error messages
    [action.h, csv.cpp, csv.h, jocsParser.cpp, jocsPlayer.cpp]
2017-03-05 Add upload backend and button to viewer gui
2017-03-06 Fixed some bugs with parsing new primatives
    [testing_all.csv]
2017-03-06 Fixed spiral and trajectory bugs, Arc still doesnt' work
    [testing_all.csv]
2017-03-06 Update design files
    [led-holder.stl, xframe-bot.stl, xframe.stl]
2017-03-06 Fixed arc, made changes to minsnap.cpp to stop set_d from asserting in CGAL
    [testing_all.csv]
2017-03-06 Fixed issue in data file with arc. Need to use time relative to start of choreo, not start of action. Also switched off GMP in minsnap because GMP was not working with non integer values in points or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
    [testing_all.csv]
2017-03-06 Support both JOCS and CSV loading as ‘Routines’
2017-03-06 Error check file opening and fix changing viewer paths
    [jocsPlayer.cpp]
2017-03-08 Distinguish between id and track/role
2017-03-08 Add id/track settings into viewer
2017-03-08 For now kill acts like ‘ctrl-c’
2017-03-15 Perspective/orthographic camera option
2017-03-26 Adding in the arduino lighting code and timing refactor
2017-03-31 Adding helix and line number messages to csv
    [hover.csv]
2017-04-01 Viewer optimizations and improve polynomial numerical stability
    [polynomial.cpp]
2017-04-03 Some tweaks from today’s runs
2017-04-08 More failsafes based on state data
    [config.h, jocsPlayer.cpp, vehicle.h]
2017-04-08 More failsafes and refinements
    [jocsPlayer.cpp, natnet.h, vehicle.h]
2017-04-10 Fix arc bug and add more docs
    [trajectory.h]
2017-04-13 Move around simulation configurations
    [cage.stl]
2017-04-13 More error checking and fix csv transformed input
    [led-holder.stl, shell.stl]
2017-04-13 Implemented strobe and Light, Bugs are likely
    [jocsParser.cpp, light.cpp, strobe.cpp, trajectory.h]
2017-04-14 Fixed light, added fade
    [csv.cpp]
2017-04-15 Finished implementation of simple light and fade. Strobe and dynamic strobe also almost working. Fixed integer division bug in set_lighting function
    [action.h, csv.cpp, light.cpp]
2017-04-15 Fixed dynamic strobe. It now works as intended
    [csv.cpp, strobe.cpp]
2017-04-15 Fixed bugs with loading light index. Removed hard coding. Fixed bug with color interpolation. Still need multiple light control. Probably will crash with current implementation
    [csv.cpp, csv.h, trajectory.h]
2017-04-16 Iterate rigid body tracker and set yaw forward direction
2017-04-17 Fixes from testing and enforce single running process
    [core.h]
2017-04-17 We now turn light off during landing. Also fixed bug with gap filling in lighting. Wasn't filling gap with lighting if there was a gap from the end of the last command to the end of the piece.
    [csv.cpp, jocsPlayer.cpp]
2017-04-20 Basic gyro calibration command
2017-04-20 Add full calibration helper
2017-04-20 Safety check max commanded thrust
2017-04-21 Lowercase filter the light indexes
2017-04-24 Skip unused columns and use any type of line break in csvs
    [csv.cpp]
2017-04-24 Drop csv test files for now (until they are updated)
    [hover.csv, testing_all.csv]
2017-04-27 Skip lines with empty csv fields
    [csv.cpp]
2017-04-28 Fix OSC for breakpoints and allow disabling lighting
    [jocsPlayer.cpp, jocsPlayer.h]
2017-05-03 Refactor feasibility checker and fix csv arc bug
    [csv.cpp, routine.h]
2017-05-11 Adding mocap yaw offset and turn off lighting on arm
2017-05-12 Add misalignment compensation and some of the single dot test code
    [jocsPlayer.cpp, vehicle.h]
2017-05-14 Fixing lighting and more failsafes
    [circleSquare.csv]
2017-05-28 Reorganize CMake for mocap and add camera interfaces
2017-05-28 Compile fixes for some platforms
    [csv.cpp]
2017-06-02 Small improvements to camera software
2017-09-04 Newer versions of json.hpp do not include iostream anymore
    Fix compile errors when using newer version
    [csv.cpp]
2017-09-04 time: fix conversion
    The intention is to check if the duration is lower than a period.
    Convert both params to int64_t.
    [ 56%] Building CXX object CMakeFiles/test_tansa.dir/test/core/time.cpp.o
    In file included from /usr/include/gtest/gtest.h:1929:0,
    from /home/user/aero-src/tansa/test/core/time.cpp:1:
    /home/user/aero-src/tansa/test/core/time.cpp: In member function ‘virtual void Time_UnitDurations_Test::TestBody()’:
    /home/user/aero-src/tansa/test/core/time.cpp:19:36: error: call of overloaded ‘abs(uint64_t)’ is ambiguous
    ASSERT_LT(abs(udur - diff.micros()), 25000);
    ^
    In file included from /usr/include/c++/7/cstdlib:75:0,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
2017-09-04 camera_node: remove cvRound on ints
2017-09-04 Fix json casting error for jocs
    [jocsParser.cpp]
2018-01-12 Add simple swap mitigation
    [mocap.h]
